lautus-creations/key-light-controller/docs/images/photos/controller-5600k.jpg

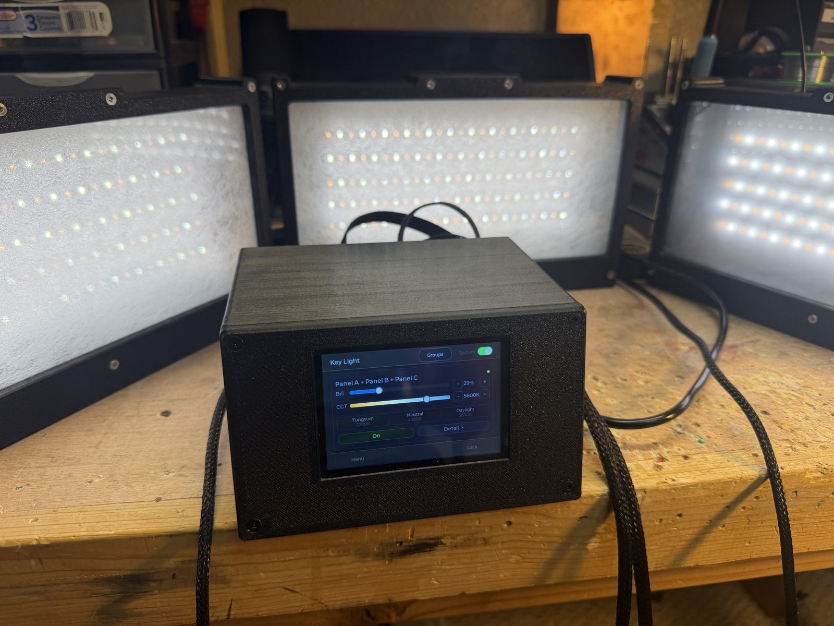
docs/images/photos/controller-5600k.jpg
