lautus-creations/key-light-controller/docs/images/photos/controller-6100k.jpg

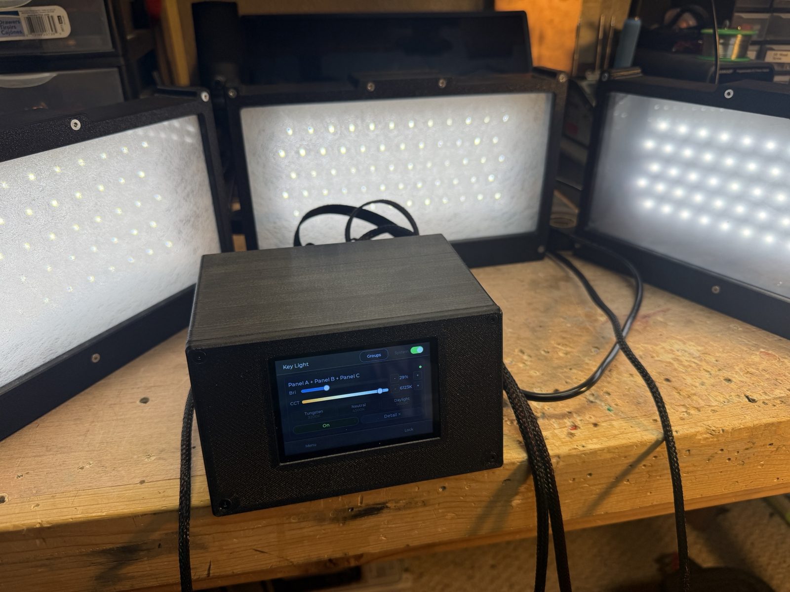
docs/images/photos/controller-6100k.jpg
