lautus-creations/key-light-controller/hardware/gerber/CCTRL_rev0.2_BOM_2026-10-24.xlsx

No. | Quantity | Comment | Designator | Footprint | Value | Manufacturer Part | Manufacturer | Supplier Part | Supplier
1 | 15 | 100nF | BK-C1,BK-C3,IN-C3,PA-C3,PA-C4,PA-C5,PA-C6,PB-C3,PB-C4,PB-C5,PB-C6,PC-C3,PC-C4,PC-C5,PC-C6 | C0603 | 100nF | CC0603KRX7R9BB104 | YAGEO(国巨) | C14663 | LCSC
2 | 1 | 22uF | BK-C2 | C1210 | 22uF | CS3225X7R226K250NRL | SAMWHA(三和) | C2918511 | LCSC
3 | 8 | B-2100S02P-A110 | BK-J1,IN-J1,PA-J2,PA-J3,PB-J2,PB-J3,PC-J2,PC-J3 | HDR-TH_2P-P2.54-V-M-1 |  | B-2100S02P-A110 | Ckmtw(灿科盟) | C124375 | LCSC
4 | 1 | PSBHAA201210H-601T053 | BK-L1 | IND-SMD_L2.0-W1.2-MWTC201208S2R2MT |  | PSBHAA201210H-601T053 | PROD(谱罗德) | C48543403 | LCSC
5 | 5 | LTST-C193TBKT-5A | BK-LED1,IN-LED1,PA-LED1,PB-LED1,PC-LED1 | LED0603-RD |  | LTST-C193TBKT-5A | LITEON(光宝) | C125103 | LCSC
6 | 5 | 1kΩ | BK-R1,MCU-R3,PA-R2,PB-R2,PC-R2 | R0603 | 1kΩ | RT0603FRE071KL | YAGEO(国巨) | C375503 | LCSC
7 | 1 | OKI-78SR-5/1.5-W36-C | BK-U1 | PWRM-TH_OKI-78SR-3.3-1.5-W36-C |  | OKI-78SR-5/1.5-W36-C | muRata(村田) | C6134431 | LCSC
8 | 1 | TP1SMB5936BT3G | BK-ZD1 | SMB_L4.3-W3.6-LS5.3-RD |  | TP1SMB5936BT3G | TECH PUBLIC(台舟) | C49452370 | LCSC
9 | 1 | 470uF | IN-C1 | CAP-TH_BD10.0-P5.00-D0.6-FD | 470uF | 01EC1316 | KNSCHA(科尼盛) | C2833298 | LCSC
10 | 7 | 10uF | IN-C2,MCU-C1,MCU-C2,MCU-C3,PA-C2,PB-C2,PC-C2 | C1210 | 10uF | CS3225X7R106K500NRL | SAMWHA(三和) | C2918502 | LCSC
11 | 1 | DB142R-5.08-2P-GN | IN-CN1 | CONN-TH_4P-P5.08_DB142R-5.08-2P-GN |  | DB142R-5.08-2P-GN | DORABO(地博电气) | C52942255 | LCSC
12 | 1 | SMCJ26A | IN-D1 | SMC_L6.9-W5.9-LS7.9-RD |  | SMCJ26A | 晶导微电子 | C438106 | LCSC
13 | 1 | XF-508P-B-B | IN-F1 | FUSE-TH_4P-L16.0-W6.7 |  | XF-508P-B-B | XFCN(兴飞) | C19727305 | LCSC
14 | 1 | AO4485 | IN-Q1 | SOIC-8_L5.0-W4.0-P1.27-LS6.0-BL |  | AO4485 | AOS | C51499 | LCSC
15 | 23 | 10kΩ | IN-R1,IN-R2,PA-R1,PA-R3,PA-R4,PA-R5,PA-R10,PA-R11,PA-R13,PB-R1,PB-R3,PB-R4,PB-R5,PB-R10,PB-R11,PB-R13,PC-R1,PC-R3,PC-R4,PC-R5,PC-R10,PC-R11,PC-R13 | R0603 | 10kΩ | RT0603FRE0710KL | YAGEO(国巨) | C469659 | LCSC
16 | 4 | LBZX84C10LT1G | IN-ZD1,PA-ZD1,PB-ZD1,PC-ZD1 | SOT-23-3_L2.9-W1.6-P1.90-LS2.8-BR |  | LBZX84C10LT1G | LRC(乐山无线电) | C12772 | LCSC
17 | 1 | 2.54-1*14P母 | MCU-CN1 | HDR-TH_14P-P2.54-V-F-1 |  | 2.54-1*14P母 | BOOMELE(博穆精密) | C52711 | LCSC
18 | 1 | B-2100S08P-A110 | MCU-CN2 | HDR-TH_8P-P2.54-V-M |  | B-2100S08P-A110 | Ckmtw(灿科盟) | C124381 | LCSC
19 | 4 | B-2100S04P-A110 | MCU-CN3,PA-J1,PB-J1,PC-J1 | HDR-TH_4P-P2.54-V-M |  | B-2100S04P-A110 | Ckmtw(灿科盟) | C124378 | LCSC
20 | 9 | PESD3V3L1BA,115 | MCU-D1,MCU-D2,MCU-D3,MCU-D4,MCU-D5,MCU-D6,MCU-D7,MCU-D8,MCU-D9 | SOD-323_L1.8-W1.3-LS2.5-BI |  | PESD3V3L1BA,115 | HXY MOSFET(华轩阳电子) | C41364896 | LCSC
21 | 1 | LTST-C193KRKT-5A | MCU-LED1 | LED0603-RD |  | LTST-C193KRKT-5A | LITEON(光宝) | C157741 | LCSC
22 | 2 | 4.7kΩ | MCU-R1,MCU-R2 | R0603 | 4.7kΩ | RT0603FRE074K7L | YAGEO(国巨) | C700513 | LCSC
23 | 1 | TS665ZJ | MCU-SW1 | SW-TH_TS665ZJ |  | TS665ZJ | SHOU HAN(首韩) | C557599 | LCSC
24 | 1 | ESP32-S3-DEVKITC-1-N16R8 | MCU-U1 (ESP32-S3) | CONN-TH_ESP32-S3-DEVKITC-1U-N8 |  | ESP32-S3-DEVKITC-1-N16R8 | ESPRESSIF(乐鑫) | C20438410 | LCSC
25 | 3 | 100uF | PA-C1,PB-C1,PC-C1 | CAP-TH_BD6.3-P2.50-D0.5-FD | 100uF | DXW050M107E122S1AA | KNSCHA(科尼盛) | C42416626 | LCSC
26 | 3 | KF2EDGV-3.81-3P | PA-CN1,PB-CN1,PC-CN1 | CONN-TH_3P-P3.81_KF2EDGV-3.81-3P |  | KF2EDGV-3.81-3P | KEFA(科发) | C441333 | LCSC
27 | 6 | SS36 | PA-D1,PA-D2,PB-D1,PB-D2,PC-D1,PC-D2 | SMA_L4.4-W2.6-LS5.0-RD |  | SS36 | TWGMC(迪嘉) | C727061 | LCSC
28 | 3 | 01550900M | PA-F1,PB-F1,PC-F1 | FUSE-SMD_L9.8-W5.0_01550900M |  | 01550900M | Littelfuse(美国力特) | C108518 | LCSC
29 | 3 | DMP6023LSS-13 | PA-Q1,PB-Q1,PC-Q1 | SOIC-8_L4.9-W3.9-P1.27-LS6.0-BL |  | DMP6023LSS-13 | DIODES(美台) | C154911 | LCSC
30 | 3 | MMBT3904 | PA-Q2,PB-Q2,PC-Q2 | SOT-23-3_L2.9-W1.3-P1.90-LS2.4-BR |  | MMBT3904 | R+O(宏嘉诚) | C7420353 | LCSC
31 | 6 | AOD4184A | PA-Q3,PA-Q4,PB-Q3,PB-Q4,PC-Q3,PC-Q4 | TO-252-2_L6.6-W6.1-P4.57-LS9.9-TL-CW |  | AOD4184A | AOS | C99124 | LCSC
32 | 6 | 47Ω | PA-R6,PA-R7,PB-R6,PB-R7,PC-R6,PC-R7 | R0603 | 47Ω | RT0603FRE0747RL | YAGEO(国巨) | C706177 | LCSC
33 | 6 | 25mΩ | PA-R8,PA-R9,PB-R8,PB-R9,PC-R8,PC-R9 | R2010 | 25mΩ | 201007F250MT4E | UNI-ROYAL(厚声) | C421879 | LCSC
34 | 3 | 100kΩ | PA-R12,PB-R12,PC-R12 | R0603 | 100kΩ | RT0603FRE07100KL | YAGEO(国巨) | C728638 | LCSC
35 | 6 | INA181A2IDBVT | PA-U1,PA-U2,PB-U1,PB-U2,PC-U1,PC-U2 | SOT-23-6_L2.9-W1.6-P0.95-LS2.8-BR |  | INA181A2IDBVT | TI(德州仪器) | C116200 | LCSC
36 | 3 | ADS1115IDGSR | PA-U3,PB-U3,PC-U3 | MSOP-10_L3.0-W3.0-P0.50-LS5.0-BL |  | ADS1115IDGSR | TI(德州仪器) | C37593 | LCSC
37 | 6 | LBZX84C5V1LT1G | PA-ZD2,PA-ZD3,PB-ZD2,PB-ZD3,PC-ZD2,PC-ZD3 | SOT-23-3_L2.9-W1.6-P1.90-LS2.8-BR |  | LBZX84C5V1LT1G | LRC(乐山无线电) | C38670 | LCSC
