lautus-creations/key-light-controller/hardware/mechanical/enclosure/pcb/Case.stl

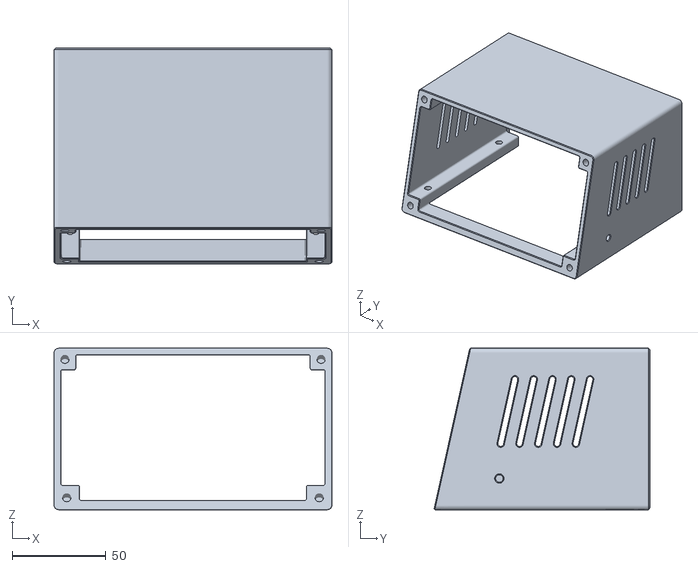
[picture p9: CAD file, 2026-10-25]
hardware/mechanical/enclosure/pcb/Case.stl
148.0 x 114.9 x 86.0
