lautus-creations/key-light-controller/hardware/mechanical/panels/reference-design/Key Light Housing.step

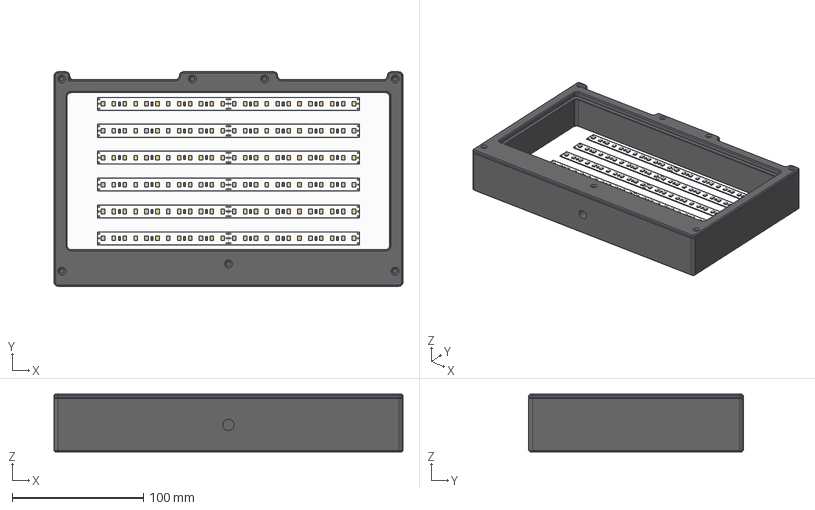
[picture p10: CAD file, 2026-10-25]
hardware/mechanical/panels/reference-design/Key Light Housing.step
266.0 x 163.5 x 44.0 mm
Aluminum Panel
Yuji LED Single Strip x 12
Case
Retainer Sleeve
Bezel
