lautus-creations/key-light-controller/hardware/mechanical/enclosure/pcb/Rear Panel.stl

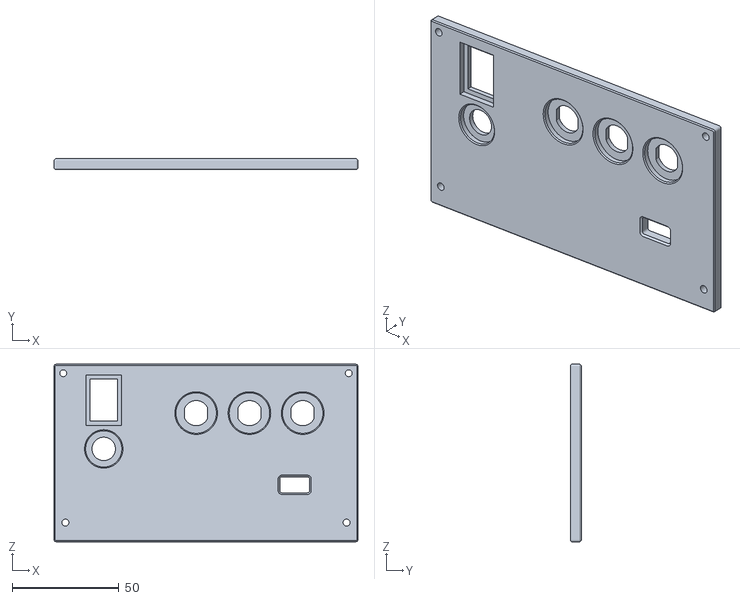
[picture p11: CAD file, 2026-10-25]
hardware/mechanical/enclosure/pcb/Rear Panel.stl
142.7 x 5.00 x 83.3
