lautus-creations/key-light-controller/hardware/mechanical/panels/reference-design/Key Light - Case.stl

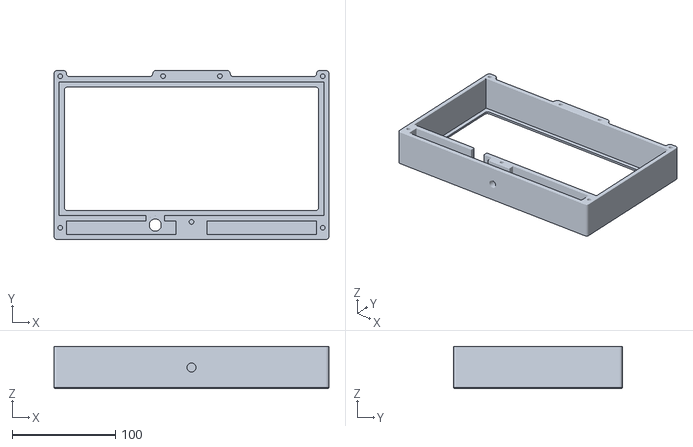
[picture p12: CAD file, 2026-10-25]
hardware/mechanical/panels/reference-design/Key Light - Case.stl
266.0 x 163.5 x 41.0
