lautus-creations/key-light-controller/hardware/mechanical/enclosure/pcb/PCB Plate Panel.stl

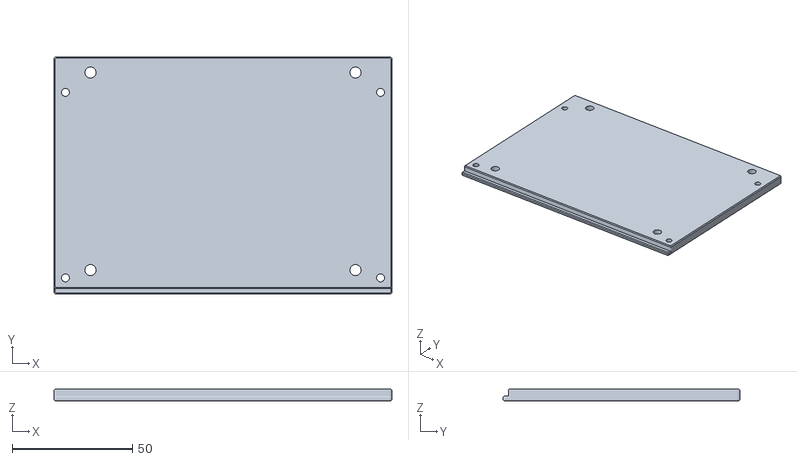
[picture p13: CAD file, 2026-10-25]
hardware/mechanical/enclosure/pcb/PCB Plate Panel.stl
140.3 x 98.5 x 5.00
