lautus-creations/key-light-controller/hardware/mechanical/panels/reference-design/Key Light - Retainer Sleeve.stl

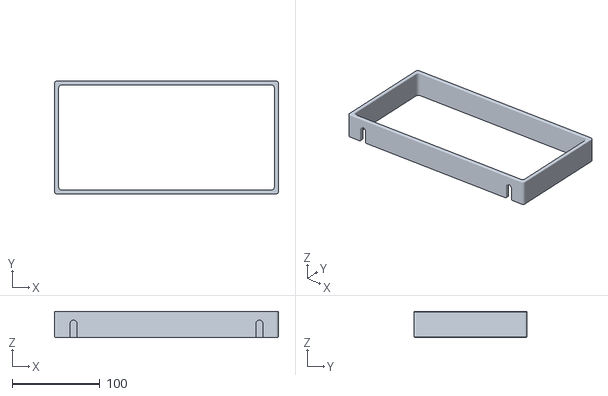
[picture p14: CAD file, 2026-10-25]
hardware/mechanical/panels/reference-design/Key Light - Retainer Sleeve.stl
255.6 x 129.1 x 30.0
