lautus-creations/key-light-controller/hardware/mechanical/enclosure/pcb/Dupont Connector Housing (Screen Side).stl

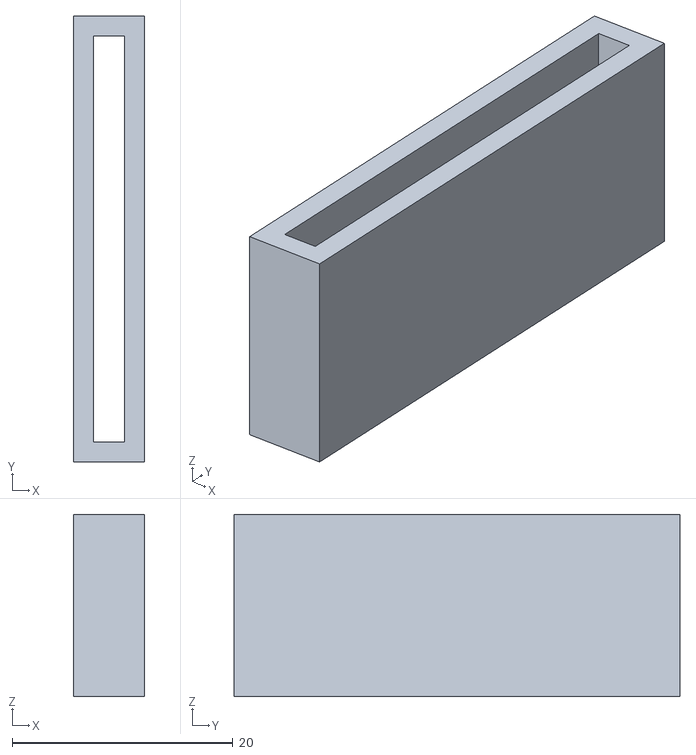
[picture p15: CAD file, 2026-10-25]
hardware/mechanical/enclosure/pcb/Dupont Connector Housing (Screen Side).stl
6.40 x 40.4 x 16.5
