lautus-creations/key-light-controller/hardware/mechanical/panels/reference-design/Key Light - Bezel.stl

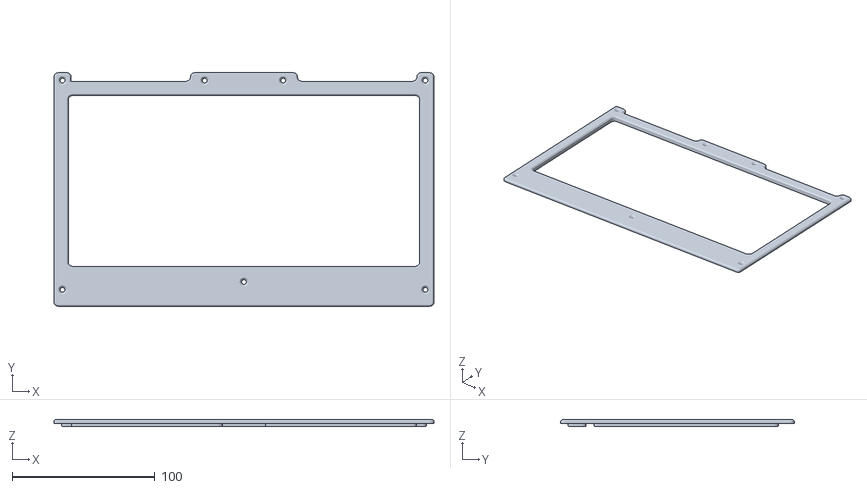
[picture p16: CAD file, 2026-10-25]
hardware/mechanical/panels/reference-design/Key Light - Bezel.stl
266.0 x 163.5 x 5.00
