lautus-creations/key-light-controller/hardware/mechanical/enclosure/pcb/Screen Panel.stl

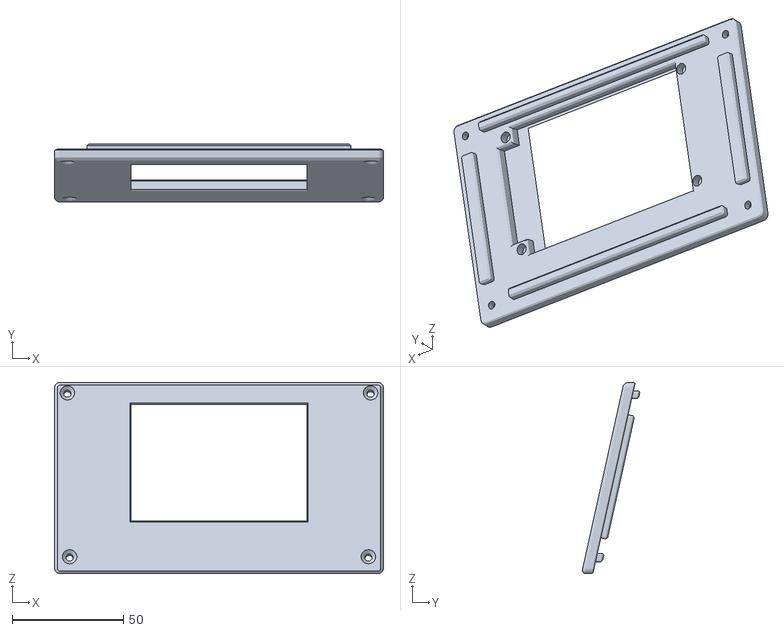
[picture p17: CAD file, 2026-10-25]
hardware/mechanical/enclosure/pcb/Screen Panel.stl
148.0 x 26.0 x 86.0
