lautus-creations/key-light-controller/(list of files, cad)

Other CAD files:
hardware/mechanical/panels/reference-design/Key Light Housing.f3z
