lautus-creations/key-light-controller/hardware/schematics/PCB_CCTRL CCTx3 rev 0.2_2026-10-24.pdf

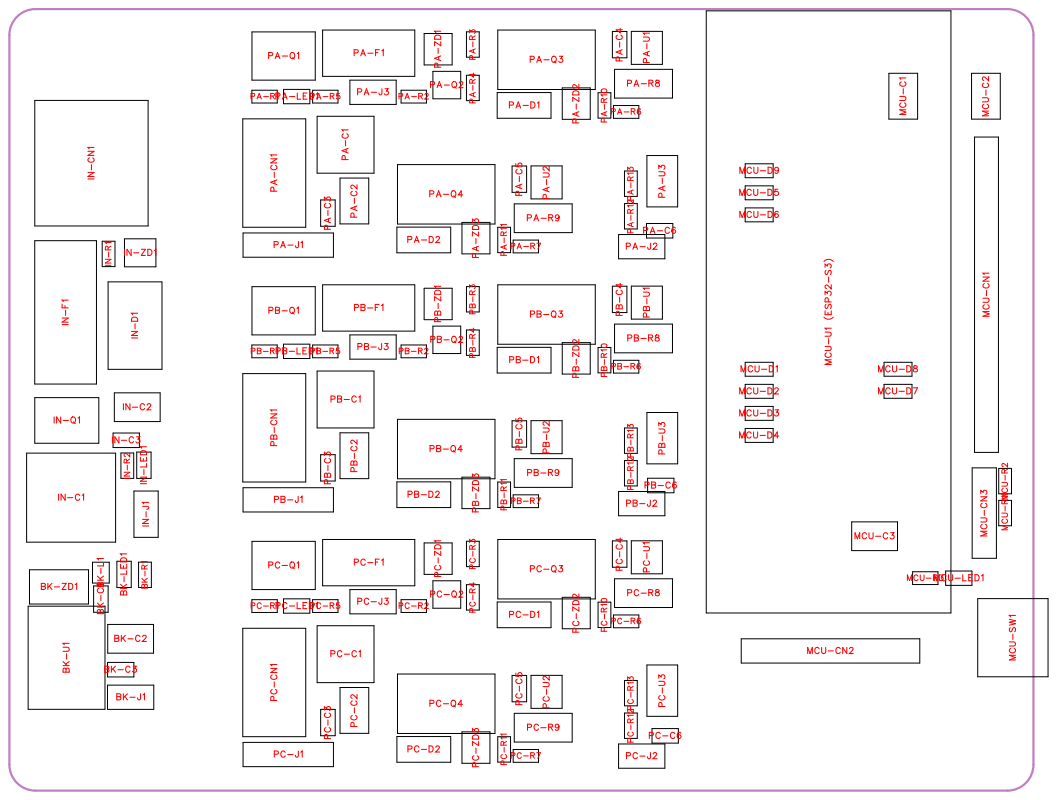
[picture p32: page 1]

No. | Quantity | Comment | Designator | Footprint | Value | Manufacturer Part | Manufacturer | Supplier Part | Supplier
1 | 15 | 100nF | BK-C1,BK-C3,IN-C3,PA-C3, PA-C4,PA-C5,PA-C6,PB-C3 ,PB-C4,PB-C5,PB-C6,PC-C 3,PC-C4,PC-C5,PC-C6 | C0603 | 100nF | CC0603KRX 7R9BB104 | YAGEO(国巨 ) | C14663 | LCSC
2 | 1 | 22uF | BK-C2 | C1210 | 22uF | CS3225X7R 226K250NRL | SAMWHA(三 和) | C2918511 | LCSC
3 | 8 | B-2100S02P-A110 | BK-J1,IN-J1,PA-J2,PA-J3,P B-J2,PB-J3,PC-J2,PC-J3 | HDR-TH_2P-P2.54-V-M-1 | | B-2100S02P-A110 | Ckmtw(灿科 盟) | C124375 | LCSC
4 | 1 | PSBHAA201 210H-601T0 53 | BK-L1 | IND-SMD_L2 .0-W1.2-MW TC201208S2 R2MT | | PSBHAA201 210H-601T0 53 | PROD(谱罗 德) | C48543403 | LCSC
5 | 5 | LTST-C193T BKT-5A | BK-LED1,IN-LED1,PA-LED 1,PB-LED1,PC-LED1 | LED0603-RD | | LTST-C193T BKT-5A | LITEON(光宝 ) | C125103 | LCSC
6 | 5 | 1k | BK-R1,MCU-R3,PA-R2,PB-R2,PC-R2 | R0603 | 1k | RT0603FRE 071KL | YAGEO(国巨 ) | C375503 | LCSC
7 | 1 | OKI-78SR-5/ 1.5-W36-C | BK-U1 | PWRM-TH_ OKI-78SR-3. 3-1.5-W36-C | | OKI-78SR-5/ 1.5-W36-C | muRata(村田 ) | C6134431 | LCSC
8 | 1 | TP1SMB593 6BT3G | BK-ZD1 | SMB_L4.3-W 3.6-LS5.3-R D | | TP1SMB593 6BT3G | TECH PUBLI C(台舟) | C49452370 | LCSC
9 | 1 | 470uF | IN-C1 | CAP-TH_BD 10.0-P5.00-D 0.6-FD | 470uF | 01EC1316 | KNSCHA(科 尼盛) | C2833298 | LCSC
10 | 7 | 10uF | IN-C2,MCU-C1,MCU-C2,M CU-C3,PA-C2,PB-C2,PC-C 2 | C1210 | 10uF | CS3225X7R 106K500NRL | SAMWHA(三 和) | C2918502 | LCSC
11 | 1 | DB142R-5.08 -2P-GN | IN-CN1 | CONN-TH_4 P-P5.08_DB 142R-5.08-2 P-GN | | DB142R-5.08 -2P-GN | DORABO(地 博电气) | C52942255 | LCSC
12 | 1 | SMCJ26A | IN-D1 | SMC_L6.9-W 5.9-LS7.9-R D | | SMCJ26A | 晶导微电子 | C438106 | LCSC
13 | 1 | XF-508P-B-B | IN-F1 | FUSE-TH_4 P-L16.0-W6. 7 | | XF-508P-B-B | XFCN(兴飞) | C19727305 | LCSC
14 | 1 | AO4485 | IN-Q1 | SOIC-8_L5.0 -W4.0-P1.27-LS6.0-BL | | AO4485 | AOS | C51499 | LCSC
15 | 23 | 10k | IN-R1,IN-R2,PA-R1,PA-R3, PA-R4,PA-R5,PA-R10,PA-R 11,PA-R13,PB-R1,PB-R3,P B-R4,PB-R5,PB-R10,PB-R1 1,PB-R13,PC-R1,PC-R3,PC -R4,PC-R5,PC-R10,PC-R11 ,PC-R13 | R0603 | 10k | RT0603FRE 0710KL | YAGEO(国巨 ) | C469659 | LCSC

16 | 4 | LBZX84C10L T1G | IN-ZD1,PA-ZD1,PB-ZD1,PC -ZD1 | SOT-23-3_L2 .9-W1.6-P1.9 0-LS2.8-BR | | LBZX84C10L T1G | LRC(乐山无 线电 ) | C12772 | LCSC
17 | 1 | 2.54-1*14P 母 | MCU-CN1 | HDR-TH_14 P-P2.54-V-F- 1 | | 2.54-1*14P 母 | BOOMELE( 博穆精密 ) | C52711 | LCSC
18 | 1 | B-2100S08P-A110 | MCU-CN2 | HDR-TH_8P-P2.54-V-M | | B-2100S08P-A110 | Ckmtw(灿科 盟) | C124381 | LCSC
19 | 4 | B-2100S04P-A110 | MCU-CN3,PA-J1,PB-J1,PC-J1 | HDR-TH_4P-P2.54-V-M | | B-2100S04P-A110 | Ckmtw(灿科 盟) | C124378 | LCSC
20 | 9 | PESD3V3L1 BA,115 | MCU-D1,MCU-D2,MCU-D3, MCU-D4,MCU-D5,MCU-D6, MCU-D7,MCU-D8,MCU-D9 | SOD-323_L1 .8-W1.3-LS2. 5-BI | | PESD3V3L1 BA,115 | HXY MOSFE T(华轩阳电子 ) | C41364896 | LCSC
21 | 1 | LTST-C193K RKT-5A | MCU-LED1 | LED0603-RD | | LTST-C193K RKT-5A | LITEON(光宝 ) | C157741 | LCSC
22 | 2 | 4.7k | MCU-R1,MCU-R2 | R0603 | 4.7k | RT0603FRE 074K7L | YAGEO(国巨 ) | C700513 | LCSC
23 | 1 | TS665ZJ | MCU-SW1 | SW-TH_TS6 65ZJ | | TS665ZJ | SHOU HAN(首韩 ) | C557599 | LCSC
24 | 1 | ESP32-S3-D EVKITC-1-N 16R8 | MCU-U1 (ESP32-S3) | CONN-TH_E SP32-S3-DE VKITC-1U-N 8 | | ESP32-S3-D EVKITC-1-N 16R8 | ESPRESSIF( ) 乐鑫 | C20438410 | LCSC
25 | 3 | 100uF | PA-C1,PB-C1,PC-C1 | CAP-TH_BD 6.3-P2.50-D0 .5-FD | 100uF | DXW050M10 7E122S1AA | KNSCHA( 科 ) 尼盛 | C42416626 | LCSC
26 | 3 | KF2EDGV-3. 81-3P | PA-CN1,PB-CN1,PC-CN1 | CONN-TH_3 P-P3.81_KF2 EDGV-3.81-3 P | | KF2EDGV-3. 81-3P | KEFA(科发 ) | C441333 | LCSC
27 | 6 | SS36 | PA-D1,PA-D2,PB-D1,PB-D2 ,PC-D1,PC-D2 | SMA_L4.4-W 2.6-LS5.0-R D | | SS36 | TWGMC( 迪 ) 嘉 | C727061 | LCSC
28 | 3 | 01550900M | PA-F1,PB-F1,PC-F1 | FUSE-SMD_ L9.8-W5.0_0 1550900M | | 01550900M | Littelfuse( 美 ) 国力特 | C108518 | LCSC
29 | 3 | DMP6023LS S-13 | PA-Q1,PB-Q1,PC-Q1 | SOIC-8_L4.9 -W3.9-P1.27-LS6.0-BL | | DMP6023LS S-13 | DIODES( 美 ) 台 | C154911 | LCSC
30 | 3 | MMBT3904 | PA-Q2,PB-Q2,PC-Q2 | SOT-23-3_L2 .9-W1.3-P1.9 0-LS2.4-BR | | MMBT3904 | R+O(宏嘉诚 ) | C7420353 | LCSC
31 | 6 | AOD4184A | PA-Q3,PA-Q4,PB-Q3,PB-Q 4,PC-Q3,PC-Q4 | TO-252-2_L6 .6-W6.1-P4.5 7-LS9.9-TL-C W | | AOD4184A | AOS | C99124 | LCSC
32 | 6 | 47 | PA-R6,PA-R7,PB-R6,PB-R7 ,PC-R6,PC-R7 | R0603 | 47 | RT0603FRE 0747RL | YAGEO(国巨 ) | C706177 | LCSC
33 | 6 | 25m | PA-R8,PA-R9,PB-R8,PB-R9 ,PC-R8,PC-R9 | R2010 | 25m | 201007F250 MT4E | UNI-ROYAL( 厚声 ) | C421879 | LCSC

34 | 3 | 100k | PA-R12,PB-R12,PC-R12 | R0603 | 100k | RT0603FRE 07100KL | YAGEO(国巨 ) | C728638 | LCSC
35 | 6 | INA181A2ID BVT | PA-U1,PA-U2,PB-U1,PB-U2 ,PC-U1,PC-U2 | SOT-23-6_L2 .9-W1.6-P0.9 5-LS2.8-BR | | INA181A2ID BVT | TI(德州仪器 ) | C116200 | LCSC
36 | 3 | ADS1115IDG SR | PA-U3,PB-U3,PC-U3 | MSOP-10_L3 .0-W3.0-P0.5 0-LS5.0-BL | | ADS1115IDG SR | TI(德州仪器 ) | C37593 | LCSC
37 | 6 | LBZX84C5V 1LT1G | PA-ZD2,PA-ZD3,PB-ZD2,P B-ZD3,PC-ZD2,PC-ZD3 | SOT-23-3_L2 .9-W1.6-P1.9 0-LS2.8-BR | | LBZX84C5V 1LT1G | LRC(乐山无 ) 线电 | C38670 | LCSC

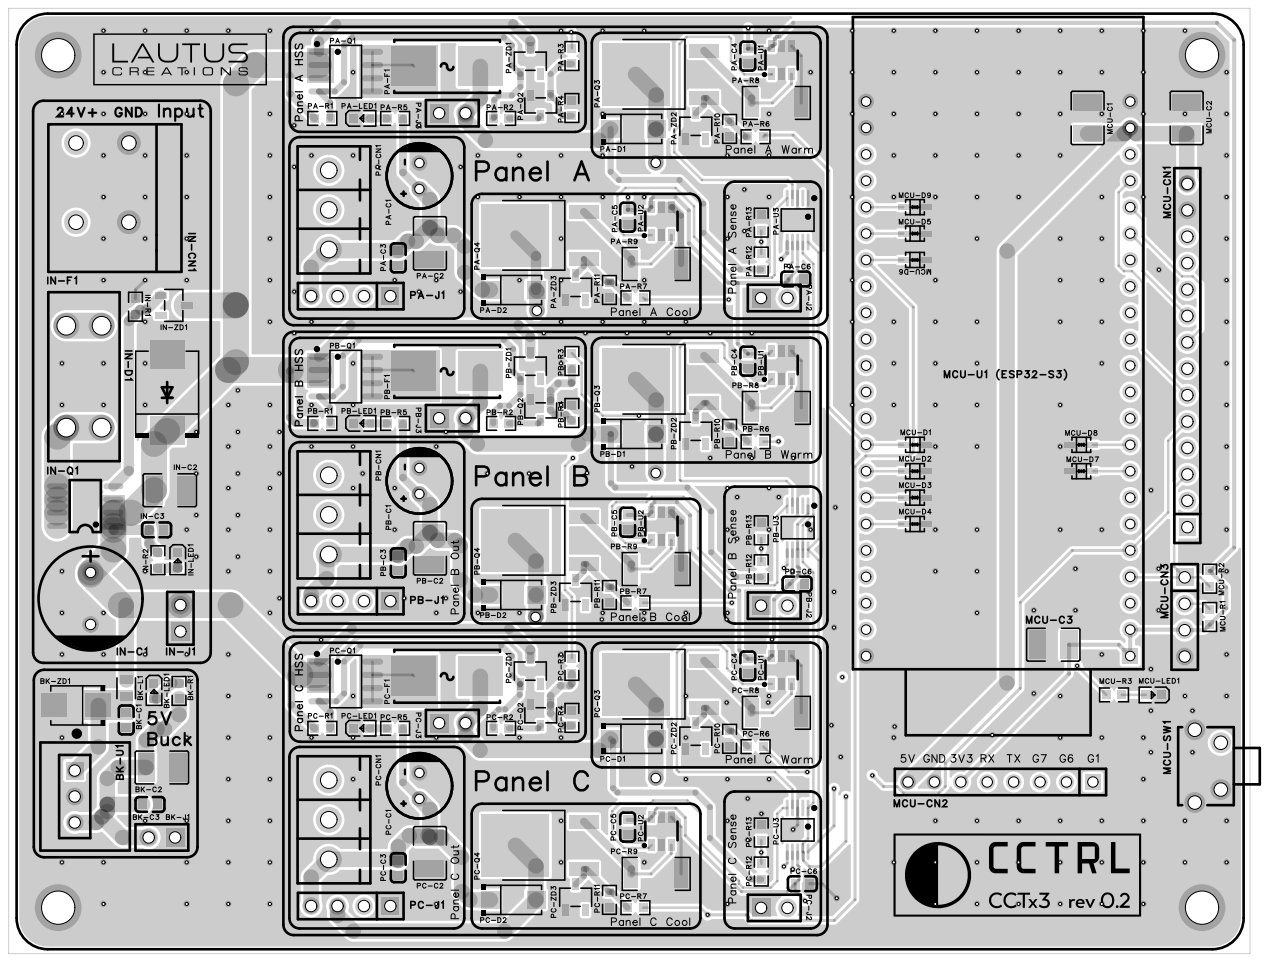
[picture p33: page 6]

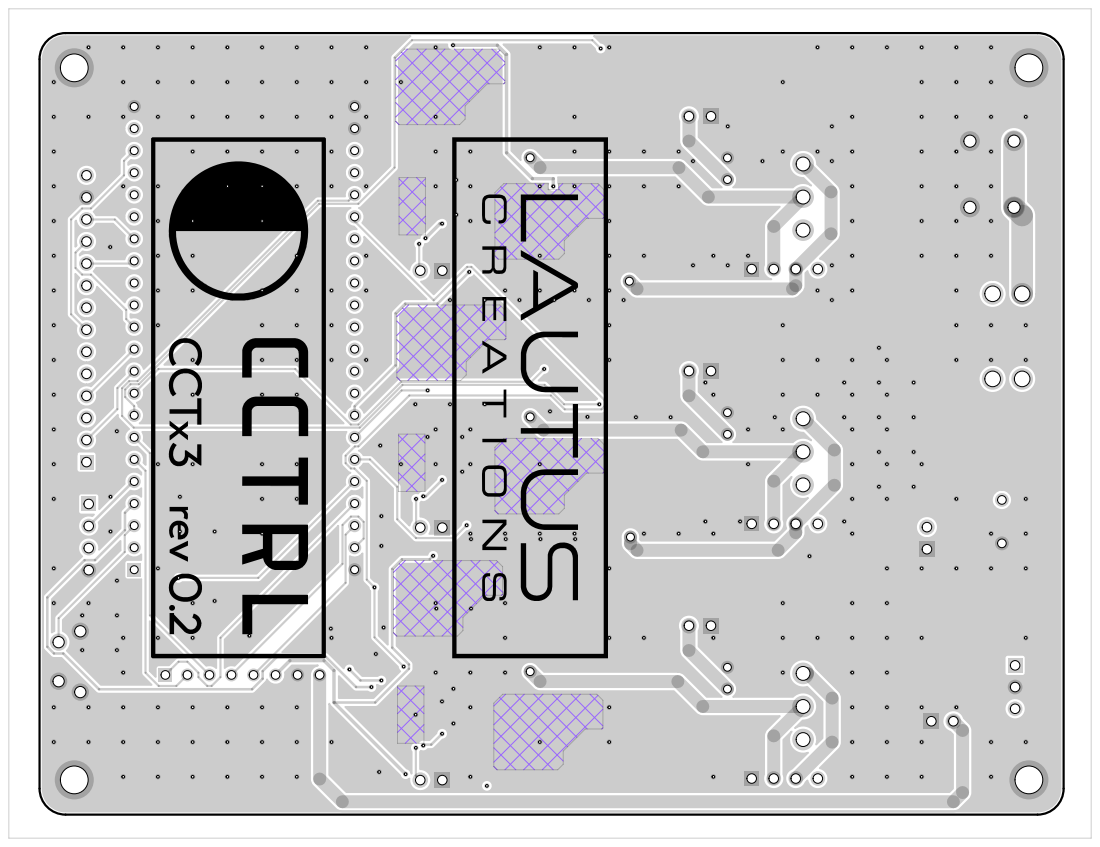
[picture p34: page 7]

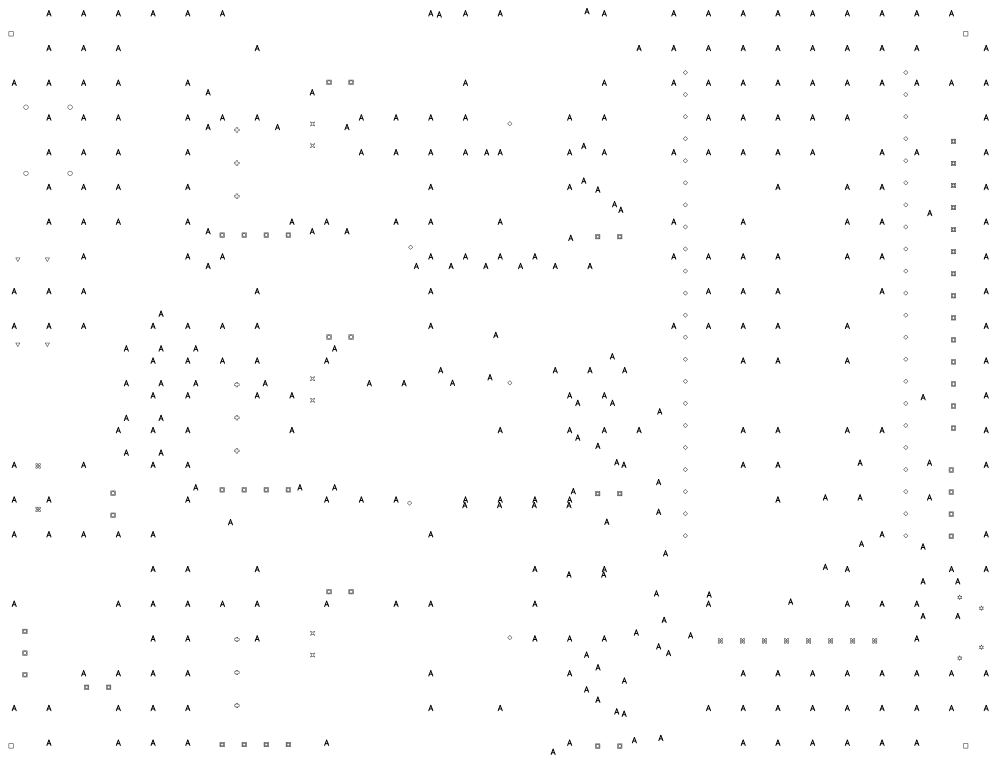
[picture p35: page 8]
