lautus-creations/key-light-controller/hardware/schematics/SCH_CCTRL CCTx3 rev 0.2_2026-10-24.pdf

# 5V Buck

# +24V_MAIN ⁺²⁴V_MAIN

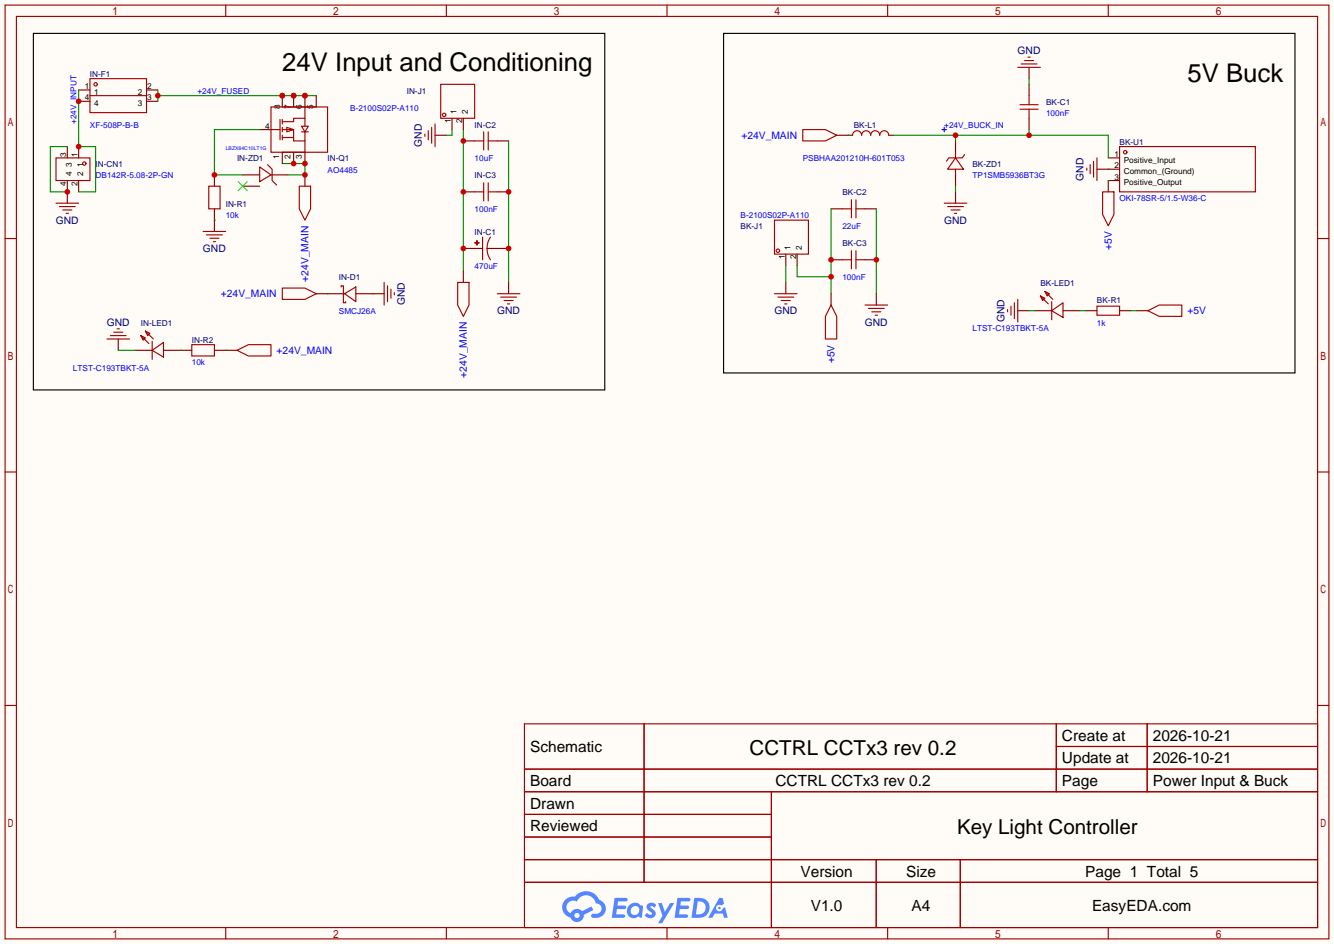
[picture p36: page 1]

Schematic | CCTRL CCTx3 rev 0.2 | Create at | 2026-10-21

Update at | 2026-10-21

Board | CCTRL CCTx3 rev 0.2 | Page | Power Input & Buck
Drawn | | Key Light Controller
Reviewed

Version | Size | Page 1 Total 5
V1.0 | A4 | EasyEDA.com

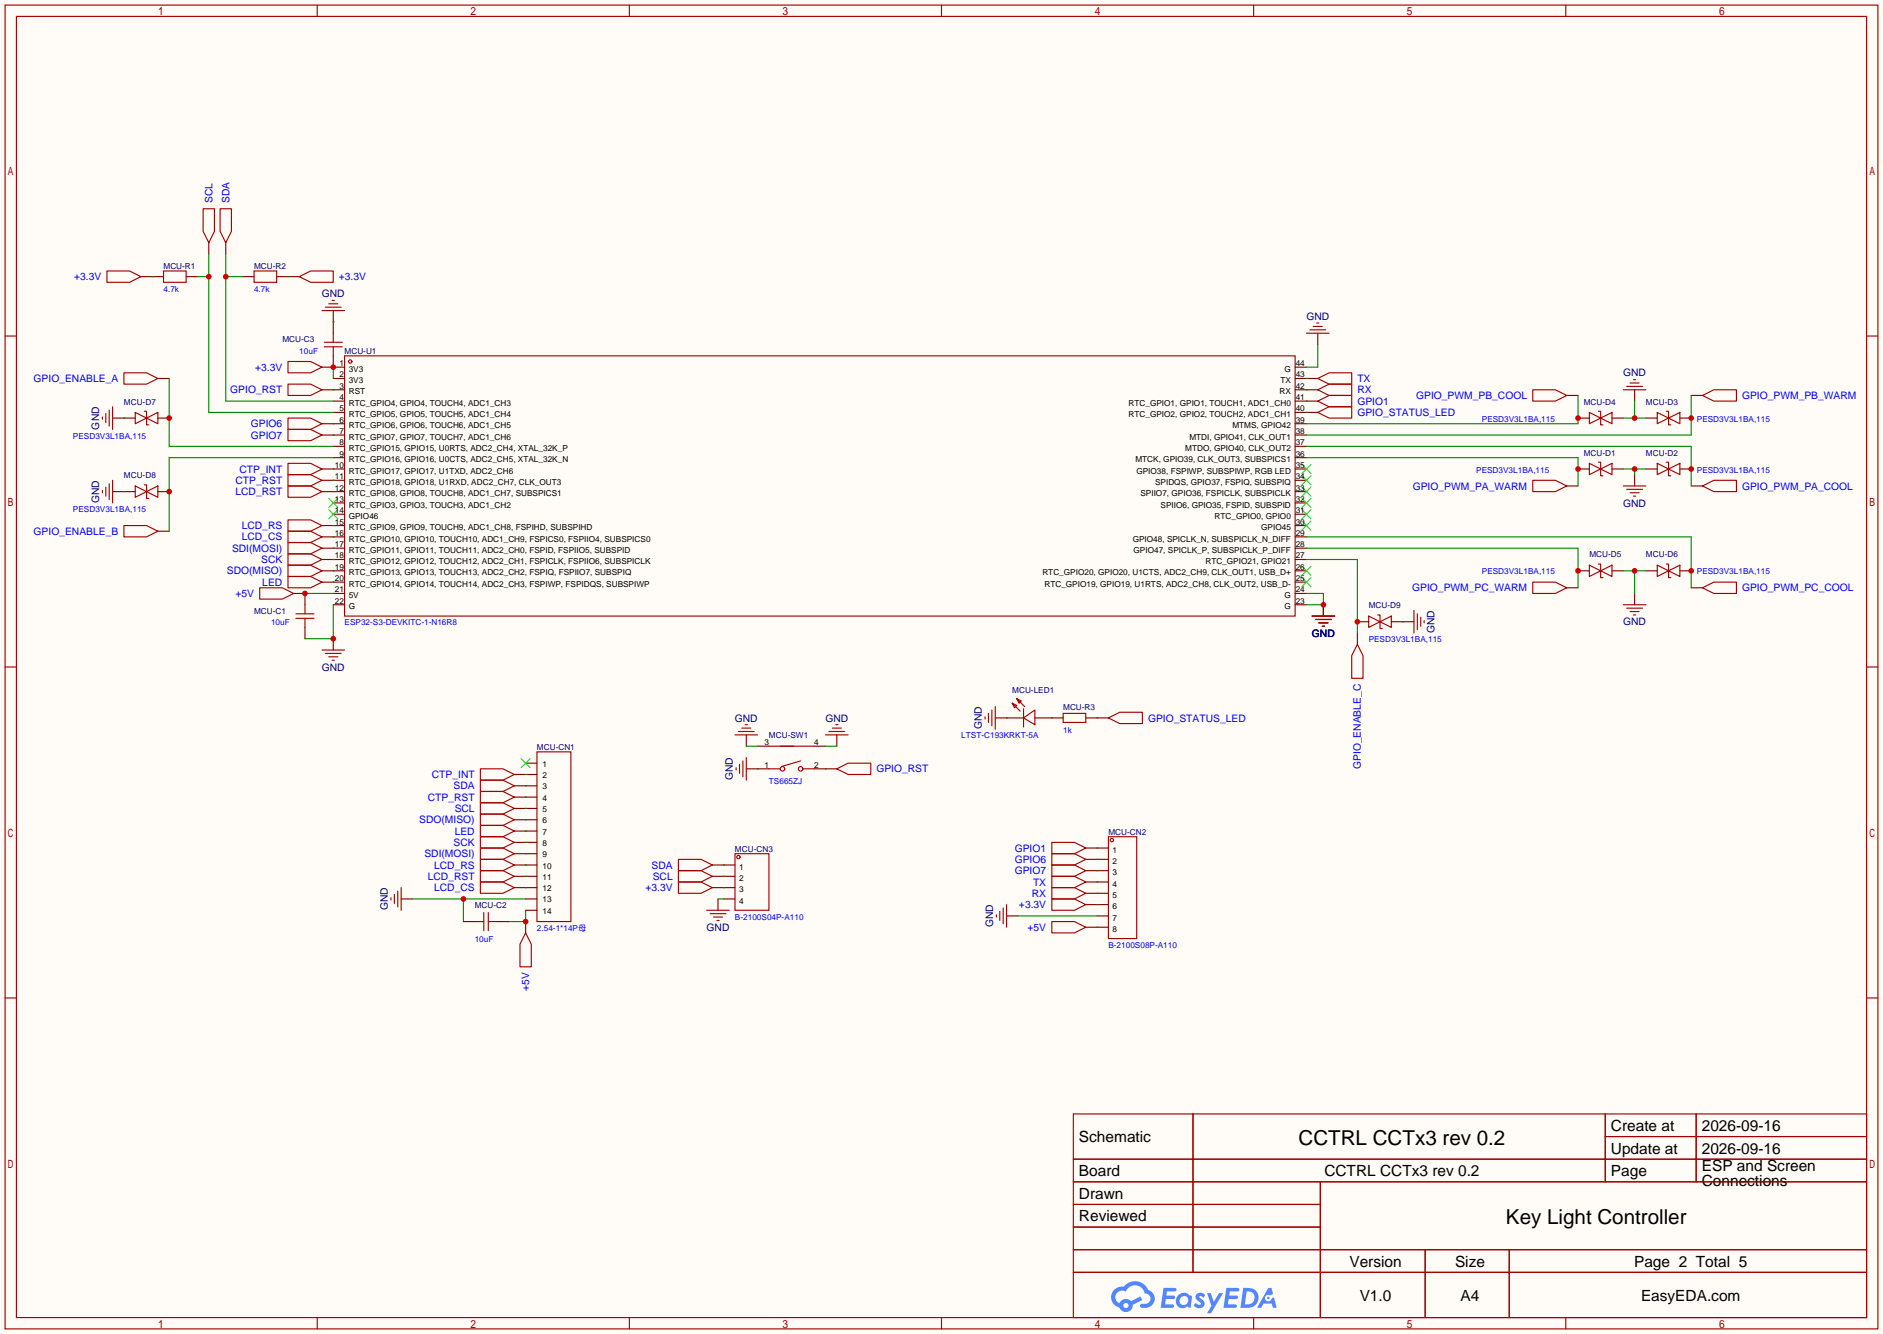
[picture p37: page 2]

24 RTC_GPIO19, GPIO19, U1RTS, ADC2_CH8, CLK_OUT2, USB_D- 25 RTC_GPIO20, GPIO20, U1CTS, ADC2_CH9, CLK_OUT1, USB_D+ 26 RTC_GPIO21, GPIO21 27 GPIO47, SPICLK_P, SUBSPICLK_P_DIFF 28 GPIO48, SPICLK_N, SUBSPICLK_N_DIFF 29 GPIO45 30 RTC_GPIO0, GPIO0 31 SPIIO6, GPIO35, FSPID, SUBSPID 32 SPIIO7, GPIO36, FSPICLK, SUBSPICLK 33 SPIDQS, GPIO37, FSPIQ, SUBSPIQ 34 GPIO38, FSPIWP, SUBSPIWP, RGB LED 35 MTCK, GPIO39, CLK_OUT3, SUBSPICS1 36 MTDO, GPIO40, CLK_OUT2 37 MTDI, GPIO41, CLK_OUT1 38 MTMS, GPIO42 39 RTC_GPIO2, GPIO2, TOUCH2, ADC1_CH1 40 RTC_GPIO1, GPIO1, TOUCH1, ADC1_CH0 41 RX 42 TX 43 G

Schematic | CCTRL CCTx3 rev 0.2 | Create at | 2026-09-16

Update at | 2026-09-16

Board | CCTRL CCTx3 rev 0.2 | Page | ESP and Screen
Drawn | | Key Light Controller
Reviewed

# Panel A High Side Switching

# Panel A Warm

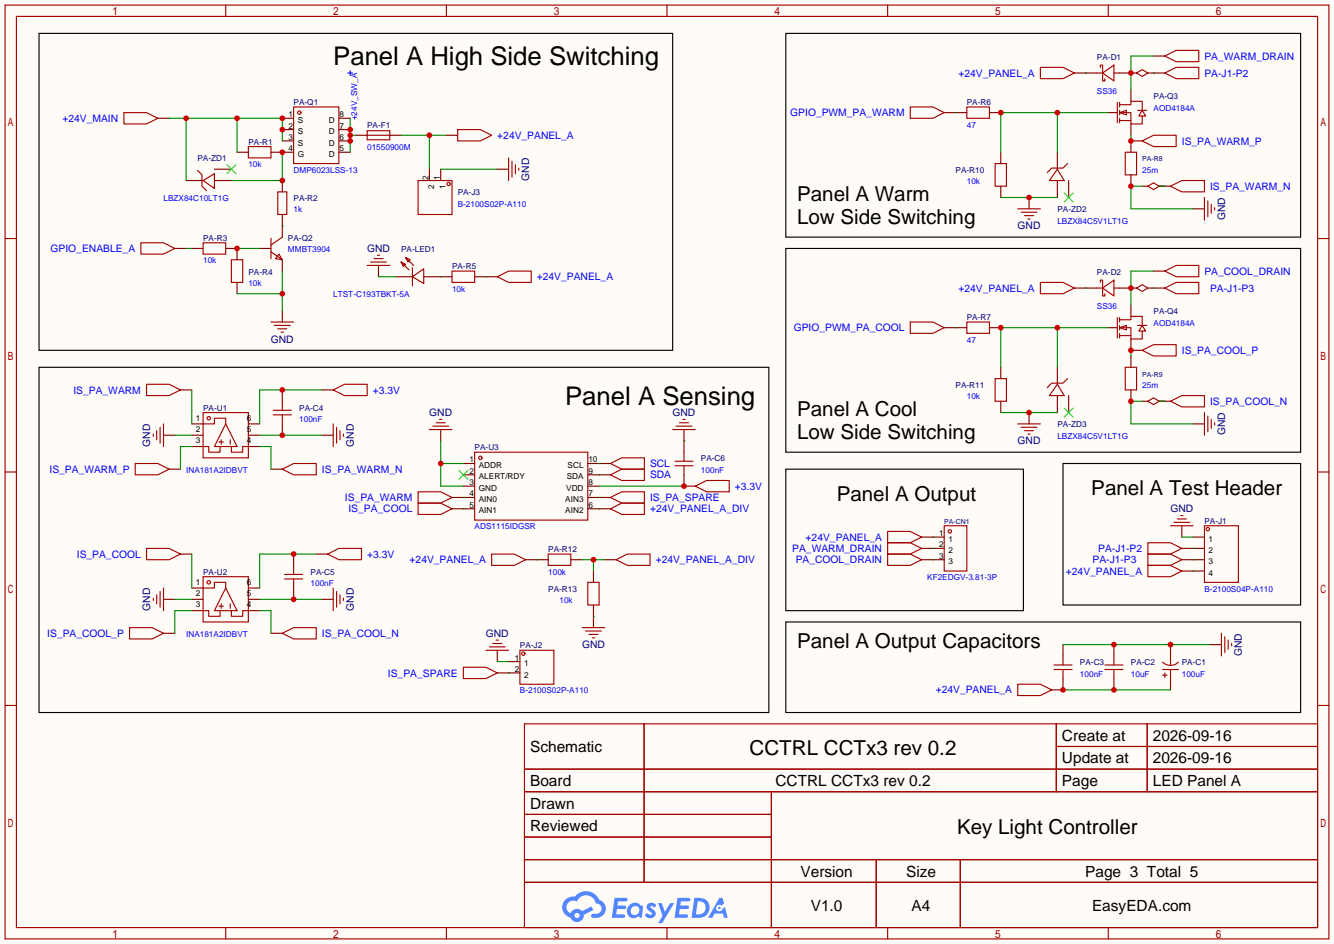
[picture p38: page 3]

Schematic | CCTRL CCTx3 rev 0.2 | Create at | 2026-09-16

Update at | 2026-09-16

Board | CCTRL CCTx3 rev 0.2 | Page | LED Panel A
Drawn | | Key Light Controller
Reviewed

# Panel B High Side Switching

# Panel B Warm

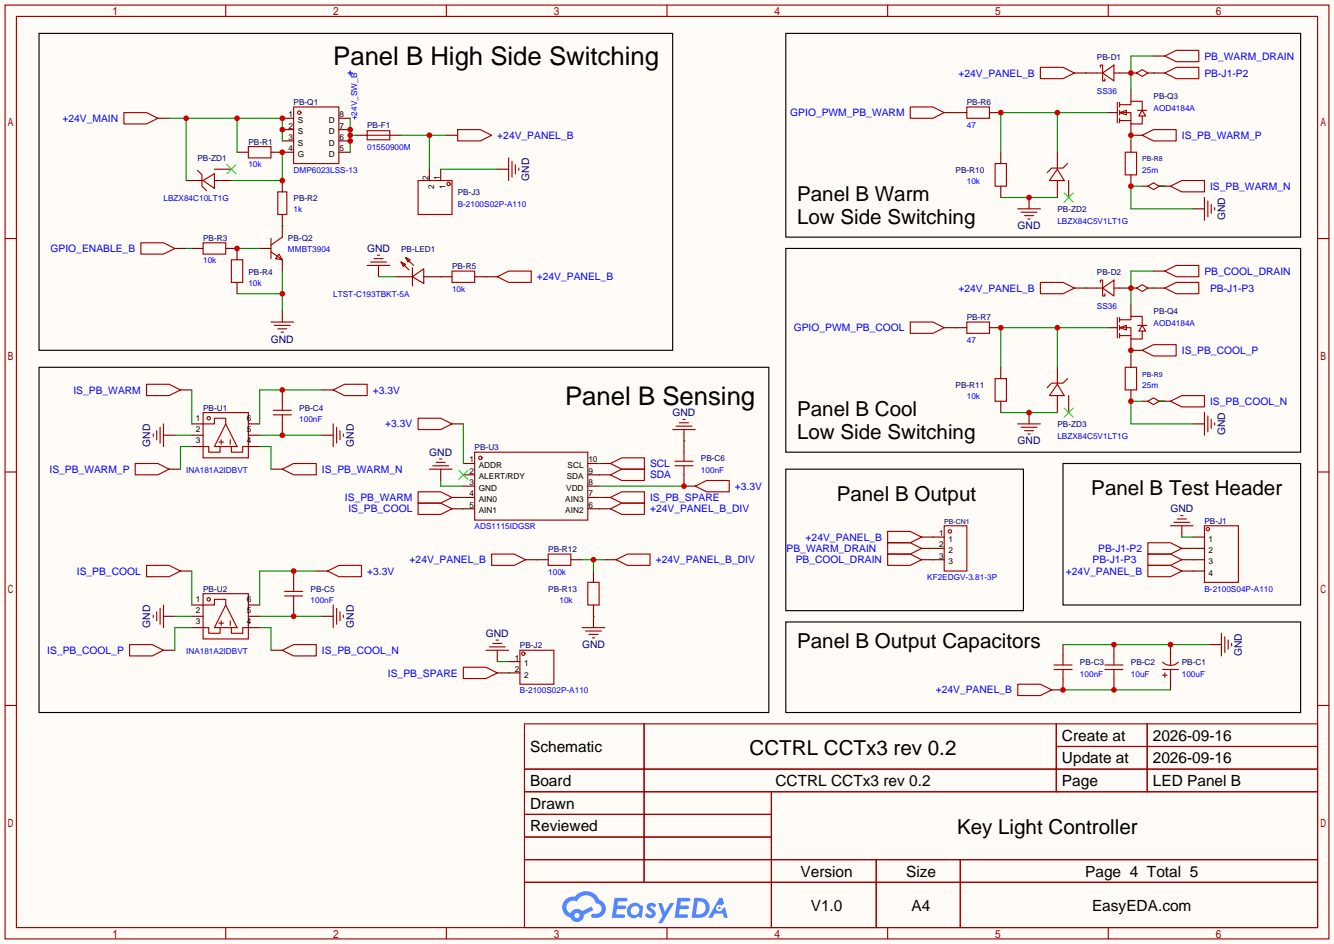
[picture p39: page 4]

Schematic | CCTRL CCTx3 rev 0.2 | Create at | 2026-09-16

Update at | 2026-09-16

Board | CCTRL CCTx3 rev 0.2 | Page | LED Panel B
Drawn | | Key Light Controller
Reviewed

# Panel C High Side Switching

# Panel C Warm

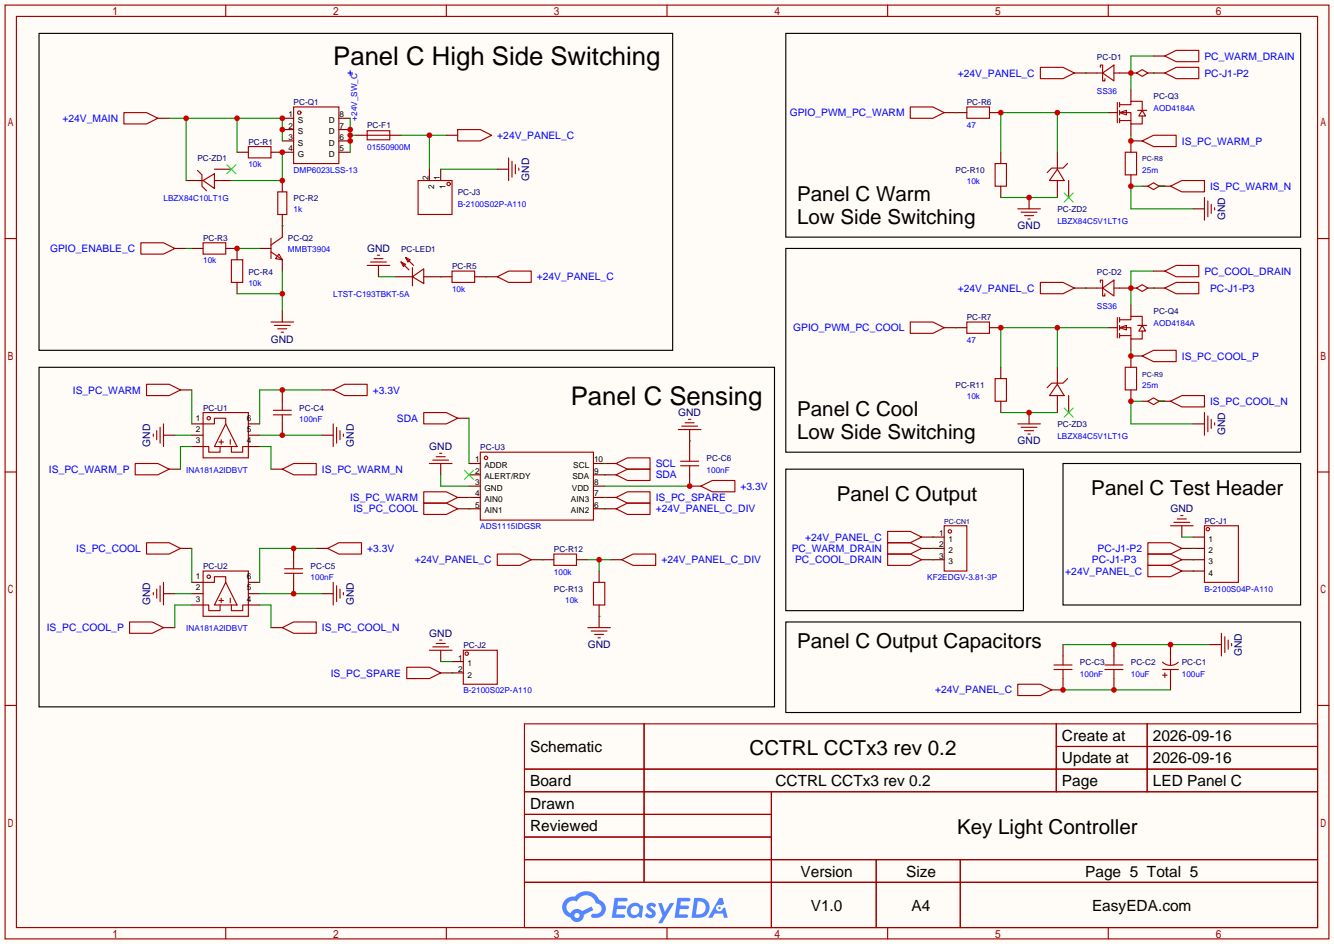
[picture p40: page 5]

Schematic | CCTRL CCTx3 rev 0.2 | Create at | 2026-09-16

Update at | 2026-09-16

Board | CCTRL CCTx3 rev 0.2 | Page | LED Panel C
Drawn | | Key Light Controller
Reviewed
