lautus-creations/key-light-controller/firmware/src/cctrl_logo.c

// SPDX-FileCopyrightText: 2026 DrEvan
// SPDX-License-Identifier: GPL-3.0-or-later

// CCTRL mark for the splash screen, 102x20, RGB565 (byte-swapped) + 8-bit alpha.
// Generated from assets/cctrl_logo_concept.svg: half-filled circle and wordmark,
// color #4A698C, alpha-blended so it sits cleanly over the bloom.

#include "lvgl.h"

static const uint8_t cctrl_logo_map[] = {
    0x4b, 0x51, 0x00, 0x4b, 0x51, 0x00, 0x4b, 0x51, 0x00, 0x4b, 0x51, 0x03, 0x4b, 0x51, 0x00, 0x4b,
    0x51, 0x0a, 0x4b, 0x51, 0x5f, 0x4b, 0x51, 0xb3, 0x4b, 0x51, 0xe4, 0x4b, 0x51, 0xf7, 0x4b, 0x51,
    0xec, 0x4b, 0x51, 0xe5, 0x4b, 0x51, 0xc4, 0x4b, 0x51, 0x6e, 0x4b, 0x51, 0x09, 0x4b, 0x51, 0x00,
    0x4b, 0x51, 0x03, 0x4b, 0x51, 0x00, 0x4b, 0x51, 0x00, 0x4b, 0x51, 0x00, 0x4b, 0x51, 0x00, 0x4b,
    0x51, 0x00, 0x4b, 0x51, 0x00, 0x4b, 0x51, 0x00, 0x4b, 0x51, 0x00, 0x4b, 0x51, 0x00, 0x4b, 0x51,
    0x00, 0x4b, 0x51, 0x00, 0x4b, 0x51, 0x00, 0x4b, 0x51, 0x00, 0x4b, 0x51, 0x00, 0x4b, 0x51, 0x00,
    0x4b, 0x51, 0x00, 0x4b, 0x51, 0x00, 0x4b, 0x51, 0x00, 0x4b, 0x51, 0x00, 0x4b, 0x51, 0x00, 0x4b,
    0x51, 0x00, 0x4b, 0x51, 0x00, 0x4b, 0x51, 0x00, 0x4b, 0x51, 0x00, 0x4b, 0x51, 0x00, 0x4b, 0x51,
    0x00, 0x4b, 0x51, 0x00, 0x4b, 0x51, 0x00, 0x4b, 0x51, 0x00, 0x4b, 0x51, 0x00, 0x4b, 0x51, 0x00,
    0x4b, 0x51, 0x00, 0x4b, 0x51, 0x00, 0x4b, 0x51, 0x00, 0x4b, 0x51, 0x00, 0x4b, 0x51, 0x00, 0x4b,
    0x51, 0x00, 0x4b, 0x51, 0x00, 0x4b, 0x51, 0x00, 0x4b, 0x51, 0x00, 0x4b, 0x51, 0x00, 0x4b, 0x51,
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
};

const lv_img_dsc_t cctrl_logo = {
    .header = {
        .cf = LV_IMG_CF_TRUE_COLOR_ALPHA,
        .always_zero = 0,
        .reserved = 0,
        .w = 102,
        .h = 20,
    },
    .data_size = 6120,
    .data = cctrl_logo_map,
};
