lautus-creations/key-light-controller/firmware/include/cctrl_logo.h

// SPDX-FileCopyrightText: 2026 DrEvan
// SPDX-License-Identifier: GPL-3.0-or-later

#pragma once
// Splash CCTRL mark bitmap, 102x20, data in cctrl_logo.c
#include <lvgl.h>

#ifdef __cplusplus
extern "C" {
#endif

extern const lv_img_dsc_t cctrl_logo;

#ifdef __cplusplus
}
#endif
