lautus-creations/key-light-controller/firmware/include/version.h

// SPDX-FileCopyrightText: 2026 DrEvan
// SPDX-License-Identifier: GPL-3.0-or-later

#pragma once

/*
 * version.h - firmware version. Do not hardcode version strings elsewhere.
 */

#define FW_VERSION  "1.2.1"
#define FW_BUILD    __DATE__
