lautus-creations/key-light-controller/(commit log)

2026-10-25 Key Light Controller: firmware v1.2.0 and controller PCB rev 0.2
    [CCTRL_rev0.2_BOM_2026-10-24.xlsx, CCTRL_rev0.2_BOM_hand-assembly.csv, CCTRL_rev0.2_PickAndPlace_2026-10-24.xlsx, Case.stl, Dupont Connector Housing (Screen Side).stl, Key Light - Bezel.stl, Key Light - Case.stl, Key Light - Retainer Sleeve.stl]
2026-10-27 Fix SYS on panel detail restoring only that group's panels
    The SYS button on the panel detail screen re-applied outputs for the
    current group only, so turning the system back on from a detail screen
    left other groups dark until touched. It now re-applies every port, as
    the home screen does.
    Firmware 1.2.1.
    Claude-Session: https://claude.ai/code/session_01LzZ818BdnJ1RqyexZ73EM5
    [screen_panel.cpp, version.h]
2026-10-27 Splash CCTRL mark, LVGL config read in place, pinned libraries
    - Splash: the CCTRL mark (from assets/cctrl_logo_concept.svg) replaces
    the "Key Light Controller" text; the stack is re-centred.
    - LVGL reads firmware/lv_conf.h via LV_CONF_PATH, so nothing needs
    copying into .pio. README build steps updated.
    - TFT_eSPI pinned to commit 16e3759, LVGL to 8.4.0.
    - tools/devkit-rev-test uses platformio/espressif32 @ 6.12.0.
    Claude-Session: https://claude.ai/code/session_01Upcz8dFe5r8fZ5hjo2ug1w
    [cctrl_logo.c, cctrl_logo.h, screen_splash.cpp]
2026-10-27 Update photos: desk setup, controller UI, panel front and lit
    - README: desk setup replaces controller-3200k.jpg as the lead photo;
    controller UI photo added below it.
    - Panel reference design: panel-lit.jpg replaces panel-leds.jpg;
    panel-front.jpg added above it.
    - New photos are 1600x1200 with EXIF/XMP removed.
    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
2026-10-27 Document enclosure hardware: inserts, standoffs and screws
    Build guide section 7, the enclosure README and the hand-assembly BOM
    now list the 20 M3 x 5 x 4 mm heat-set inserts, 4 M3 x 6 mm standoffs,
    8 M3 x 4 (or 6) mm socket head cap screws and 12 M3 x 8 mm flat head
    screws, with where each goes. The assembly steps cover the inserts.
    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
    [CCTRL_rev0.2_BOM_hand-assembly.csv]
2026-10-27 Document panel hardware: M3 inserts and screws, 1/4-20 inserts
    Panel reference-design README gets a per-panel hardware list (7 M3
    heat-set inserts, 7 M3 flat head screws, one or two 1/4-20 heat-set
    inserts) with totals for three panels; build guide section 8 points
    to it.
    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
2026-10-27 Link the aluminum backing plate used in the reference panels
    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
2026-10-27 Give the panel backing plate size: 5 x 10 x 0.125 in
    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
2026-10-27 Give the 1/4-20 heat-set insert dimensions used in the panels
    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
2026-10-27 Document the panel diffuser: 3 mm acrylic with Rosco 3006 film
    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
2026-10-27 Add safety and liability notice; US spellings; doc fixes
    - Safety and liability notice near the top of the README, build guide,
    user guide, hardware README and panel reference-design README:
    hazards, voluntary assumption of risk, "as is" and "with all faults",
    no liability, in addition to the licenses' own terms.
    - US spellings throughout docs and code comments (color, center,
    canceled, labeled, gray, initialize, license); the serial console's
    "[CHECK] Cancelled" now reads "Canceled".
    - Build guide: tack the DevKit socket headers with the DevKit fitted,
    then remove it before soldering the rest, and keep heat brief.
    - Fuse table: drop the 1 A minimum for the panel Nano2 fuse.
    Co-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
    [app_state.h, board_pins.h, cctrl_logo.c, fault_ui.cpp, fault_ui.h, lock.cpp, main.cpp, panel_check.cpp]
2026-10-31 Add issue templates and contributing guide
    - Issue forms: a bug or fault report (firmware version, board revision,
    DevKit type, panels and power, serial output) and a build question,
    with links to the build and user guides.
    - CONTRIBUTING.md: when to open an issue first, hardware and firmware
    expectations, contributions licensed under the license of the part
    they change, and a note on changes to the protection design.
    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
